TaylorMatson/Automated-Panel-Solar-Unit/High Level Design.docx

# Control Methodology

JOG

MODE

GPS

MODE

PHOTO

MODE

ARDUINO

ACTUATOR

1

ACTUATOR

2

RELAY

1

RELAY

2

RELAY

3

RELAY

4

# Power Management

Solar Panel

POWER

DISTRIBUTOR

12V BATTERY

5V USB ARDUINO

5V USB ILLUMINATED SIGN

ACTUATOR RELAYS
