TaylorMatson/Automated-Panel-Solar-Unit/Documentation/Customer Wishlist (containing the customer input, contraints, wishes, expectations).docx

Customer Wishes

CW#001

The solar panel array mounted on the unit must be 2 feet by 3 feet in area.

Taylor Matson

3/15/2021

CW#002

The branding of Austin Peay State University must be branded on the project.

Nick Calin

3/15/2021

CW#003

The unit must track the Sun to maximize power input efficiency.

Nathan Lamotte

3/15/2021

CW#004

The unit must be weatherproof and require minimal maintenance for long durations of its lifespan.

Taylor Matson

3/15/2021

CW#005

The unit must contain a microprocessor.

Nathan Lamotte

3/15/2021
