TaylorMatson/Automated-Panel-Solar-Unit/Requirement Specifications.docx

Requirement Specification

For our project to work it will need to meet all of the required specifications for maximum efficiency.

- Needs to be outside on flat land to provide stability and in view of the Sun all day.
- Needs to have enough space for both axes to move.
- This product can not withstand significant bending force during transportation & construction.
- There must be a WiFi access point called “APSU Solar Project” with the password “solarproject”
