TaylorMatson/Automated-Panel-Solar-Unit/Documentation/Mechanical Diagram.png

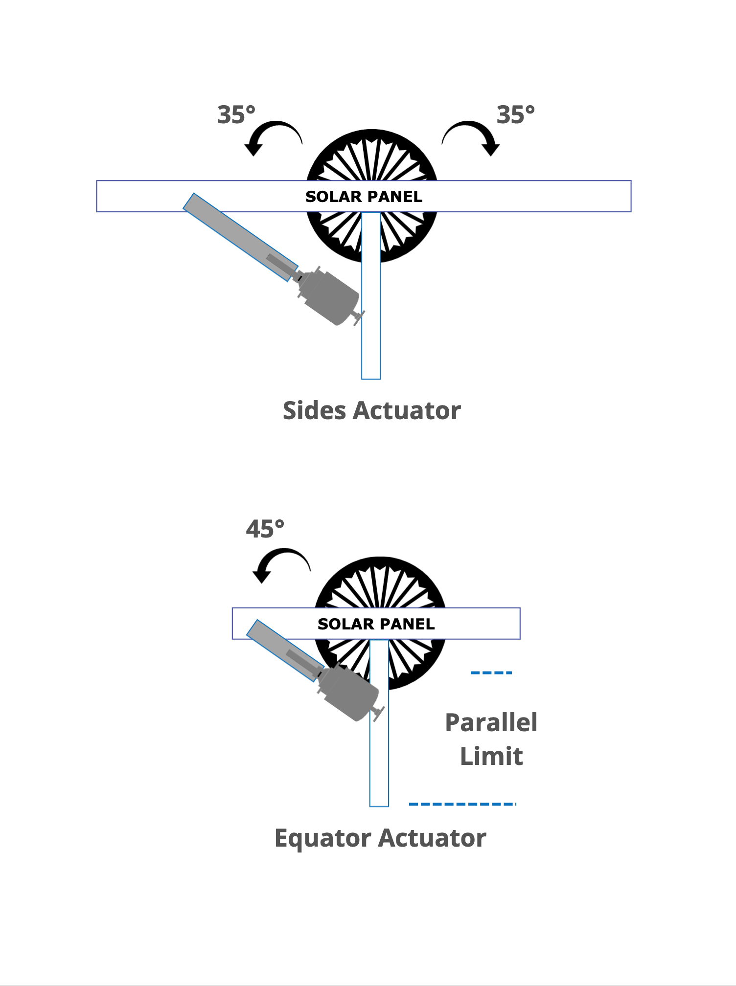
Documentation/Mechanical Diagram.png
