TaylorMatson/Automated-Panel-Solar-Unit/Electrical Diagrams/Photoresistor CIrcuit.png

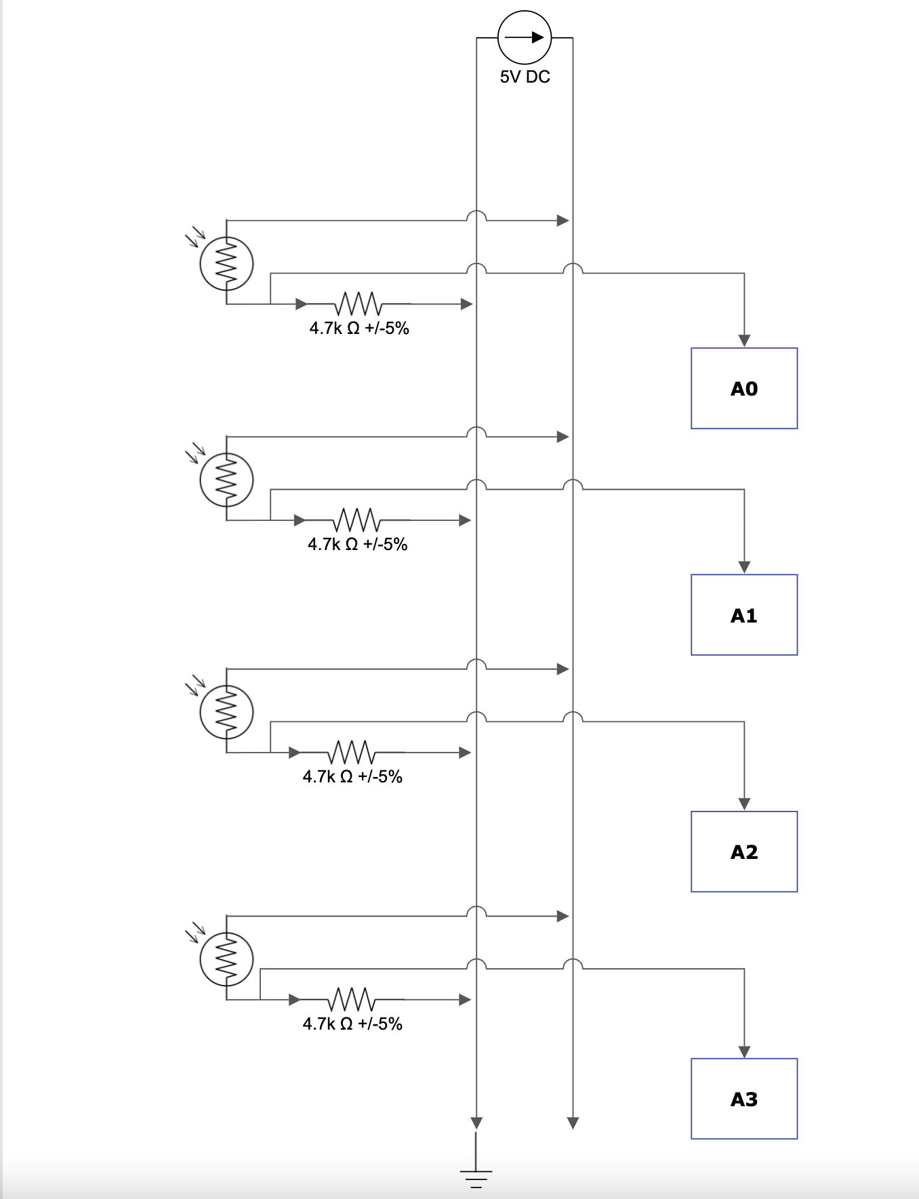
Electrical Diagrams/Photoresistor CIrcuit.png
