TaylorMatson/Automated-Panel-Solar-Unit/Electrical Diagrams/photoresistor.jpg

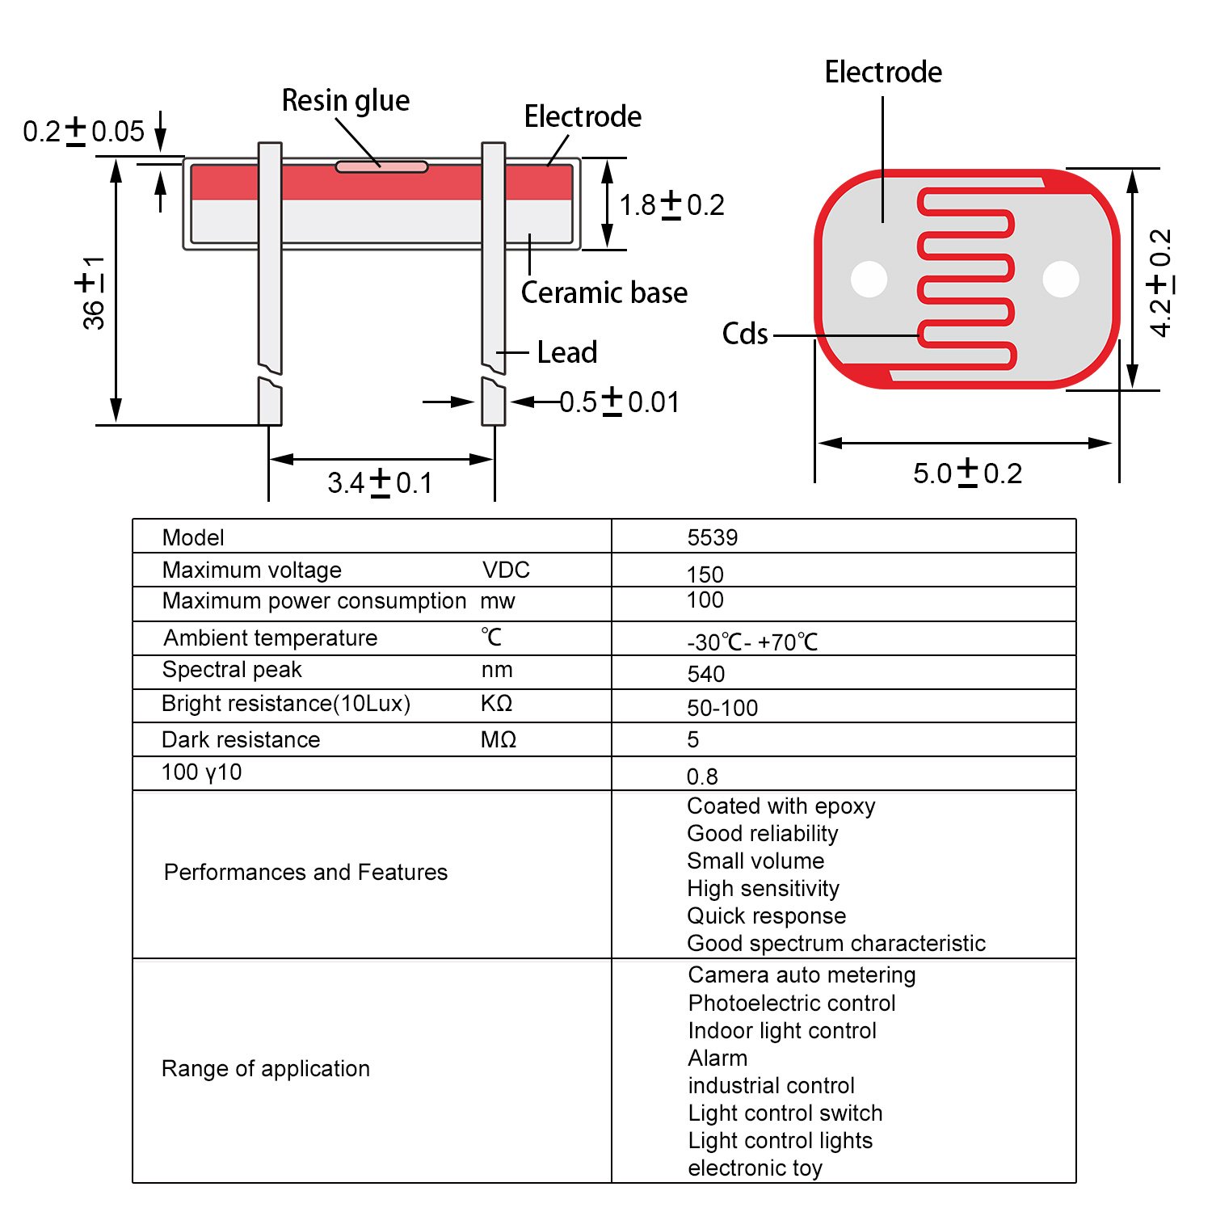
Electrical Diagrams/photoresistor.jpg
