TaylorMatson/Automated-Panel-Solar-Unit/Electrical Diagrams/Relay TO Actuator CIrcuit.PNG

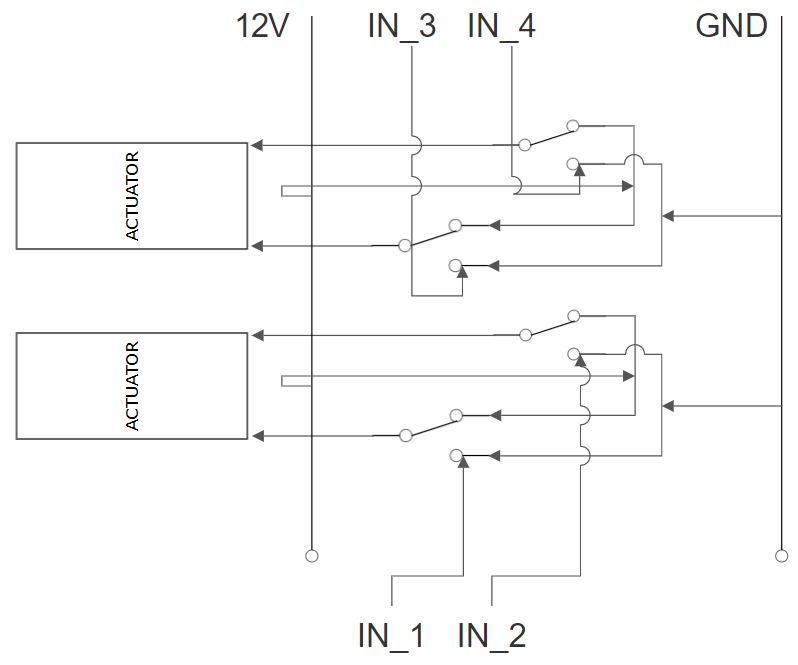
Electrical Diagrams/Relay TO Actuator CIrcuit.PNG
