TaylorMatson/Automated-Panel-Solar-Unit/Documentation/Automated Panel Solar Array Parts List.xlsx

Revised Parts List |  |  | We can pick up Grainger products physically to save on shipping costs
Electical
4 Channel Relay Module | $8.73 | 1 | https://www.amazon.com/ELEGOO-Channel-Optocoupler-Arduino-Raspberry/dp/B01HEQF5HU/?th=1
12" Actuator with Hardware | $45.87 | 1 | https://www.amazon.com/ECO-WORTHY-330lbs-Tracker-Actuator-Multi-function/dp/B00NM8H5SW
6" Actuator with Hardware | $36.25 | 1 | https://www.amazon.com/dp/B07H1TCBBV
Photoresistors | $4.97 | 1 | https://www.amazon.com/eBoot-Photoresistor-Sensitive-Resistor-Dependent/dp/B01N7V536K
Arduino WiFi | $49.01 | 1 | https://www.amazon.com/Arduino-UNO-WiFi-REV2-ABX00021/dp/B07MK598QV/ (https://www.amazon.com/HiLetgo-ATmega328P-ESP8266-NodeMCU-USB-TTL/dp/B0834JQ5Y5)
Black EEEKit 30A Solar Charge Controller | $13.10 | 1 | https://www.amazon.com/EEEKit-Controller-Intelligent-Multi-Function-Adjustable/dp/B08NQTW94B/
Solar Panel | $195.56 | 1 | https://www.amazon.com/ECO-WORTHY-Monocrystalline-Battery-Charging-Caravan/dp/B07TTSL2M6
12v Battery | $19.12 | 1 | https://www.amazon.com/ML7-12-Battery-Mighty-Brand-Product/dp/B00K8V30D0
10 and 25 Series 2 Hole Pivot Joint | $47.26 | 2 | https://www.amazon.com/80-20-Inc-14011-Pivot/dp/B07ZS1TDD6
 | $419.87
Hardware
Tee Joining Plate | $10.91 | 1 | https://www.amazon.com/Boeray-10pcs-Joining-Aluminum-Profile/dp/B01H4YPT64
Joining Plate | $47.36 | 1 | https://www.amazon.com/80-20-2-Hole-Joining-Strip/dp/B00J3TMTBW/
Fastening Hardware | $33.38 | 2 | https://www.amazon.com/80-20-Inc-Assembly-Slide/dp/B00FDSEOWY/
1/4"-20 High Speed Steel 2 Flute Spiral Point Tap | $6.06 | 1 | https://www.amazon.com/Drill-America-DWT57129-Qualtech-High-Speed/dp/B00BD5Q0BE/
Framing | $90.41 | 2 | https://www.amazon.com/gp/product/B001F0F112/
T-slot Piviot Joint | $49.33 | 2 | https://www.amazon.com/80-20-Inc-14011-Pivot/dp/B07ZS1TDD6/
 | $237.45
 | .
Total | $657.32
Purchasing Office: | tamayom@apsu.edu
Correspondant: | tmatson@my.apsu.edu
Missing From Parts Retrieval
Fastening Hardware | $33.38 | 2 | https://www.amazon.com/80-20-Inc-Assembly-Slide/dp/B00FDSEOWY/
