TaylorMatson/Automated-Panel-Solar-Unit/Documentation/External Costs.xlsx

Name | Cost
Make Nashville Membership | $105
Solar Panel Power Cables | $24.77
Photosensor Arduino Kit | $65.54
Junction Box | $31.67
 | $226.98
