TaylorMatson/Automated-Panel-Solar-Unit/2021Workbook(AutomatedPanelSolarUnit).xlsx

Sheet: 0 TOC
Project Workbook - Table of Content
ID | Title (Abbreviation) | Short decription; Instruction when to use the sheet
0 | Table of Contents (TOC) | Feel free to add other sheets as needed
1 | Project Order (PO) | Contains the initial order and key project data; This sheet is to be filled in before the project start and must not be changed during the project!
2 | Project Estimate (PE) | Contains the initial estimate (ideas, budget/costs,…); This sheet is to be filled in before the project start and must not be changed during the project!
3.x | Status per Reporting Period (ST) | This sheet contains the actual satus of the ongoing project at fixed interval times; This sheet is to be copied and filled in at each reporting interval!
4 | Customer Wishes (CW) | Statements made by the customer during meetings that have a direct influence to the project; This sheet is to be filled in after the first customer meeting and has to be updated on demand using a Change Request!
5 | User Stories (US) | The product from the view of different stakeholders and how they are going to use / produce it; This sheet is to be filled in after the first customer meeting and has to be updated on demand using a Change Request!
6 | Schedule in Hours (SH) | Contains workpackages and phases with daily time scheduling; This sheet is to be filled in at the project start and should be updated each beginning of an hour with all changes!
7 | Project Log (PL) | Contains all action items, change requests, risks, decisions that are currently open, in work or closed; This sheet is a log file and should be filled in and updated with each project change!
8 | Communication Plan (COM) | List of meeting and communication channels and Identification and management of key stakeholders for the project; This sheet is to be filled in after the first customer meeting and has to be updated on demand using a Change Request!
9 | Document Management (DOC) | Records documents used in realtion to the project.
10.x | Meeting Minutes (MM) | Use this sheet as a template for recording meetings; This sheet is to be filled in during each meeting!
11 | Revision History (REV) | Shows revision history of project workbook
12 | Change Requests (CR) | Details any Change Requests submitted along with other Action Items and risk evaluations.
13 | Glossary | Definition and description of used acronyms and terminology; This sheet is to be filled with all used acronyms!

Sheet: 1 PO
Project Title: | Automated Panel Solar Unit (APSU) |  | 0-TOC
Customer | Mr.Anderson | Planned Start Date: | 2021-03-15
Project Manager: | Taylor Matson | Planned End Date: | 2021-08-06
Document Owner: | Taylor Matson, Nathan LaMotte, Nick Calin
Project Background
Short Project Description
Dual axis soloar panel array, with integrated micro processor to automatically track the sun throughout the day to maximize solor panel output.
Decision for Starting this Project
Out of all of the project ideas we came up with, this one was calculated to be the most doable. Considering costs, construction, implementation, and timeline an Automated Panel Solar Array was our best option.
Initial Objectives
To establish a list of goals and expectations with the customer. To determine the bill of materials and timeline in which objectives would be completed.
Preliminary Scope/Requirements/Constraints
The solar panel arrary for mounted on the unit must be 2 feet by 3 feet in area. The branding of Austin Peay State University must be branded on the project. The unit must track the Sun to maximize power input effeciency. The unit must be weather proof and require minimal maitenance for long durations of its lifespan. The unit must contain a microprocessor.

Sheet: 2 PE
Preliminary Estimate
Project Title: |  | Automated Panel Solar Unit (APSU) |  |  |  |  |  |  | 0-TOC
Document Owner: |  | Taylor Matson, Nathan LaMotte, Nick Calin
Project Preliminary Estimate
Initial Solution Ideas/Alternatives
Because this is a student project, the actual cost is a profit for the institution as they take our course fees to fund our professor who oversees the project. The only cost to the institution is the material cost. Although we were budgeted $500 USD, the project would not be fulfillable as the actual least expensive and custom method we could determine is $740 USD. That being said, the institution has slack in the budget to fund us with additional finances if we need it. To what extent those additional resources are, we do not know yet.
Preliminary Internal Key Assumptions and Constraints (e.g. Timing, Resources, Process, Technology, Regulatory)
Timing restraints are dictated by the semester schedule our University imposes on courses. That being said, as student we can continue to work between semesters as the capstone course is broken up into two seperate semesters. The University is allocating a budget of $500 USD to our project with additional funds being made necessary as we need it. For us students, we are coming out of pocket for gasoline, food, and other non-essential items needed to complete this project. The technology required for this project is very simple as we only need low level programming to automate the panels actuators. We will be following the regulatory standard for electronics in outdoor settings that are for low voltage and current applications with power storage.
Initial Estimate of Project Parameters
Given Budget [€] |  |  |  | 500 €
External Consultant Cost [€] |  |  |  | 0 €
Material Costs [€] |  |  |  | 658 €
Low Cost Effort [h] |  |  |  | 400 | at pay [€] | 20 €
Mid Cost Effort [h] |  |  |  | 200 | at pay [€] | 40 €
High Cost Effort [h] |  |  |  | 150 | at pay [€] | 60 €
Planned Product Cost [€] |  |  |  | 25658 €
Budget - Costs [€] |  |  |  | -25158 €
Initial Risk Assessment
Schedule | g
Scope | g
People | g
Defects | g
Decisions | g
Costs | g
Suppliers | g
Milestones
Milestone |  | End Date | End Day | Comment
Complete Concept |  | 2021-01-30 | 2021-02-15 | Completed
Complete Systems Design |  | 2021-02-28 | 2021-03-30 | Completed
Complete Parts List |  | 2021-03-30 | 2021-04-30 | Completed
Complete Construction |  | 2021-05-30 | 2021-06-20 | Completed
Complete Final Interation |  | 2021-06-20 | 2021-07-20 | Not Initiated
Ship to Customer |  | 2021-07-20 | 2021-07-30 | Not Initiated
Initial Skill Assessment
Identify needed skills and knowledge for this project |  |  |  |  |  |  | Available | Needed | Action Item
C Programmer |  |  |  |  |  |  | x
AutoCAD Designer |  |  |  |  |  |  | x
Administration |  |  |  |  |  |  | x
Secretary/Accounting |  |  |  |  |  |  | x
Project Manager |  |  |  |  |  |  | x
Metal Shop Fabrication |  |  |  |  |  |  | x
Electrical Systems Engineer |  |  |  |  |  |  | x

Sheet: 3.1 ST
Project Status
Project Title: | Automated Panel Solar Unit (APSU) |  |  |  |  |  | 0-TOC
Date: | 2021.04.05 | 15:30:00
Document Owner: |  | Taylor Matson, Nathan LaMotte, Nick Calin
Current Project Parameters
 |  |  |  | Initial | Last Status | Spent | Available
Budget |  |  |  | 500 € | 500 € | 0 € | 500 €
Low Cost Effort |  |  |  | 500 | 500 | 0 | 500
Mid Cost Effort |  |  |  | 600 | 600 | 0
High Cost Effort |  |  |  | 700 | 700 | 0 € | 700
External Cost |  |  |  | 0 € | 0 € | 0 € | 0 €
Status
Status |  | Comments on Status (neccessary if status is yellow or red)
Schedule | g | Nothing to report
Scope | g | Nothing to report
People | g | Nothing to report
Defects | g | Nothing to report
Decisions | g | Nothing to report
Costs | g | Our parts list did go over budget but the University is allocating more resources.
Risks | g | Nothing to report
Trend | Ò
Milestones
MS 00 - Project Order |  | g | Order will be submitted within 30 days.
MS 01 - Initialization |  | g | Nothing to report
MS 02 - Execution |  | g | Nothing to report
MS 03 - Monitoring |  | g | Nothing to report
MS 04 - Closing |  | g | Nothing to report
MS 05 - Closure |  | g | Nothing to report
Key Issues and Achievements
Parts list in the process of being submitted to the budget office.

Sheet: 3.2 ST
8
Project Title: | Automated Panel Solar Unit (APSU) |  |  |  |  |  | 0-TOC
Date: | 2021.5.4 | 14:30:00
Document Owner: |  | Taylor Matson, Nathan LaMotte, Nick Calin
Current Project Parameters
 |  |  |  | Initial | Last Status | Spent | Available
Budget |  |  |  | 500 € | 658 € | 657.32 € | 0.68 €
Low Cost Effort |  |  |  | 500 | 500 | 500 | 0
Mid Cost Effort |  |  |  | 600 | 600 | 600
High Cost Effort |  |  |  | 700 | 700 | 657.32 € | 42.68
External Cost |  |  |  | 0 € | 0 € | 0 € | 0 €
Status
Status |  | Comments on Status (neccessary if status is yellow or red)
Schedule | g | Nothing to report
Scope | g | Nothing to report
People | g | Nothing to report
Defects | g | Nothing to report
Decisions | g | Nothing to report
Costs | g | Nothing to report
Risks | g | Nothing to report
Trend | Ò
Milestones
MS 00 - Project Order |  | g | Order submitted to Ms. Tamayo
MS 01 - Initialization |  | g | Nothing to report
MS 02 - Execution |  | g | Nothing to report
MS 03 - Monitoring |  | g | Nothing to report
MS 04 - Closing |  | g | Nothing to report
MS 05 - Closure |  | g | Nothing to report
Key Issues and Achievements
Initial order submitted.

Sheet: 3.3 ST
8
Project Title: | Automated Panel Solar Unit (APSU) |  |  |  |  |  | 0-TOC
Date: | 2021.6.16 | 14:30:00
Document Owner: |  | Taylor Matson, Nathan LaMotte, Nick Calin
Current Project Parameters
 |  |  |  | Initial | Last Status | Spent | Available
Budget |  |  |  | 500 € | 658 € | 657.32 € | 0.68 €
Low Cost Effort |  |  |  | 500 | 500 | 500 | 0
Mid Cost Effort |  |  |  | 600 | 600 | 600
High Cost Effort |  |  |  | 700 | 700 | 657.32 € | 42.68
External Cost |  |  |  | 0 € | 0 € | 0 € | 0 €
Status
Status |  | Comments on Status (neccessary if status is yellow or red)
Schedule | y | We are currently two meeting behind due to emergencies and incomplete work.
Scope | g
People | g
Defects | y | Arduino WiFi off brand version almost broke my computer, had to reinstall OS.
Decisions | g
Costs | r | Team is out of pocket for wiring, Make Nashville membership, and junction box.
Risks | g
Trend | Ü | Nathan and Taylor are one week behind schedule and Nick is behind 4 weeks.
Milestones
MS 00 - Project Order |  | g | External purchases we're made to fulful the project demands
MS 01 - Initialization |  | g
MS 02 - Execution |  | y
MS 03 - Monitoring |  | g
MS 04 - Closing |  | g
MS 05 - Closure |  | g
Key Issues and Achievements
Final design completed. Aluminum extrusions cut to size by Nathan.

Sheet: 3.4 ST
8
Project Title: | Automated Panel Solar Unit (APSU) |  |  |  |  |  | 0-TOC
Date: | 2021.7.6 | 14:30:00
Document Owner: |  | Taylor Matson, Nathan LaMotte, Nick Calin
Current Project Parameters
 |  |  |  | Initial | Last Status | Spent | Available
Budget |  |  |  | 500 € | 658 € | 657.32 € | 0.68 €
Low Cost Effort |  |  |  | 500 | 500 | 500 | 0
Mid Cost Effort |  |  |  | 600 | 600 | 600
High Cost Effort |  |  |  | 700 | 700 | 657.32 € | 42.68
External Cost |  |  |  | 0 € | 0 € | 227 € | 0 €
Status
Status |  | Comments on Status (neccessary if status is yellow or red)
Schedule | y | We are currently two meeting behind due to emergencies and incomplete work.
Scope | g
People | g
Defects | g
Decisions | g
Costs | r | Had to order legit Arduino WiFi and Junction Box $65.50 + $31.67
Risks | g
Trend | Ü | Nathan and Taylor are two weeks behind schedule and Nick is behind 6 weeks.
Milestones
MS 00 - Project Order |  | g
MS 01 - Initialization |  | g
MS 02 - Execution |  | g | Construction of the initial version completed with WiFi control.
MS 03 - Monitoring |  | g
MS 04 - Closing |  | g
MS 05 - Closure |  | g
Key Issues and Achievements

Sheet: 4 CW
Customer Wishes
Project Title: | Automated Panel Solar Unit (APSU) |  | 0-TOC
Document Owner: | Taylor Matson, Nathan LaMotte, Nick Calin
Customer Wish List
ID | Wish | Author | Date
CW#001 | The solar panel array mounted on the unit must be 2 feet by 3 feet in area. | Taylor Matson | 2021-03-15
CW#002 | The branding of Austin Peay State University must be branded on the project. | Nick Calin | 2021-03-15
CW#003 | The unit must track the Sun to maximize power input efficiency. | Nathan Lamotte | 2021-03-15
CW#004 | The unit must be weatherproof and require minimal maintenance for long durations of its lifespan. | Taylor Matson | 2021-03-15
CW#005 | The unit must contain a microprocessor. | Nathan Lamotte | 2021-03-15

Sheet: 5 US
User Stories
Project Title: | Automated Panel Solar Unit (APSU) |  |  | 0-TOC
Document Owner: | Taylor Matson, Nathan LaMotte, Nick Calin
User Story List
ID | Related Wish ID (if possible) | User Story | Author | Date
US#001 |  | Customer needs this solar array to track the sun for maximum efficiency. Because the university is receiving a grant for new innovations in global warming research, the project needs to provide accurate data that scientists across the world can use. | Mattew Anderson | 3.15.2021
US#002
US#003
US#004
US#005
Invest | Meaning | Description
I | Independent | The user story should be self-contained, in a way that there is no inherent dependency on another user story.
N | Negotiable | User stories, up until they are part of an implementation, can always be changed and rewritten.
V | Valuable | A user story must deliver value to the end user.
E | Estimable | You must always be able to estimate the size of a user story.
S | Small | User stories should not be so big as to become impossible to plan/task/prioritize with a certain level of certainty.
T | Testable | The user story or its related description must provide the necessary information to make test development possible.

Sheet: 6 SD
Schedule
Project Title: | Automated Panel Solar Unit (APSU) |  |  |  |  | 0-TOC | Current Day: |  |  |  |  | 64.78681794
Work Packages |  |  |  |  |  |  | Time Schedule in d
 |  |  |  |  |  | Calender Week | 42 | 42 | 42 | 42 | 42 | 43 | 43 | 43 | 43 | 43 | 44 | 44 | 44 | 44 | 44 | 45 | 45 | 45 | 45 | 45 | 46 | 46 | 46 | 46 | 46 | 47 | 47 | 47 | 47 | 47 | 48 | 48 | 48 | 48 | 48 | 49 | 49 | 49 | 49 | 49 | 50 | 50 | 50 | 50 | 50 | 51 | 51 | 51 | 51 | 51 | 52 | 52
ID | Predecessor ID (if existing) | Responsible Person | Start | Planned End | Adjusted End | Percentage of Completion (estimate) | 1 | 2 | 3 | 4 | 5 | 6 | 7 | 8 | 9 | 10 | 11 | 12 | 13 | 14 | 15 | 16 | 17 | 18 | 19 | 20 | 21 | 22 | 23 | 24 | 25 | 26 | 27 | 28 | 29 | 30 | 31 | 32 | 33 | 34 | 35 | 36 | 37 | 38 | 39 | 40 | 41 | 42 | 43 | 44 | 45 | 46 | 47 | 48 | 49 | 50 | 51 | 52
1 |  | Taylor Matson | 2 | 16 | 22 | 100% | 1 | 2 | 3 | 4 | 5 | 6 | 7 | 8 | 9 | 10 | 11 | 12 | 13 | 14 | 15 | 16 | 17 | 18 | 19 | 20 | 21 | 22 | 23 | 24 | 25 | 26 | 27 | 28 | 29 | 30 | 31 | 32 | 33 | 34 | 35 | 36 | 37 | 38 | 39 | 40 | 41 | 42 | 43 | 44 | 45 | 46 | 47 | 48 | 49 | 50 | 51 | 52
2 |  | Taylor Matson | 15 | 16 | 16 | 100% | 1 | 2 | 3 | 4 | 5 | 6 | 7 | 8 | 9 | 10 | 11 | 12 | 13 | 14 | 15 | 16 | 17 | 18 | 19 | 20 | 21 | 22 | 23 | 24 | 25 | 26 | 27 | 28 | 29 | 30 | 31 | 32 | 33 | 34 | 35 | 36 | 37 | 38 | 39 | 40 | 41 | 42 | 43 | 44 | 45 | 46 | 47 | 48 | 49 | 50 | 51 | 52
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
27 |  |  |  |  |  | 0% | 1 | 2 | 3 | 4 | 5 | 6 | 7 | 8 | 9 | 10 | 11 | 12 | 13 | 14 | 15 | 16 | 17 | 18 | 19 | 20 | 21 | 22 | 23 | 24 | 25 | 26 | 27 | 28 | 29 | 30 | 31 | 32 | 33 | 34 | 35 | 36 | 37 | 38 | 39 | 40 | 41 | 42 | 43 | 44 | 45 | 46 | 47 | 48 | 49 | 50 | 51 | 52
28 |  |  |  |  |  | 0% | 1 | 2 | 3 | 4 | 5 | 6 | 7 | 8 | 9 | 10 | 11 | 12 | 13 | 14 | 15 | 16 | 17 | 18 | 19 | 20 | 21 | 22 | 23 | 24 | 25 | 26 | 27 | 28 | 29 | 30 | 31 | 32 | 33 | 34 | 35 | 36 | 37 | 38 | 39 | 40 | 41 | 42 | 43 | 44 | 45 | 46 | 47 | 48 | 49 | 50 | 51 | 52
29 |  |  |  |  |  | 0% | 1 | 2 | 3 | 4 | 5 | 6 | 7 | 8 | 9 | 10 | 11 | 12 | 13 | 14 | 15 | 16 | 17 | 18 | 19 | 20 | 21 | 22 | 23 | 24 | 25 | 26 | 27 | 28 | 29 | 30 | 31 | 32 | 33 | 34 | 35 | 36 | 37 | 38 | 39 | 40 | 41 | 42 | 43 | 44 | 45 | 46 | 47 | 48 | 49 | 50 | 51 | 52
30 |  |  |  |  |  | 0% | 1 | 2 | 3 | 4 | 5 | 6 | 7 | 8 | 9 | 10 | 11 | 12 | 13 | 14 | 15 | 16 | 17 | 18 | 19 | 20 | 21 | 22 | 23 | 24 | 25 | 26 | 27 | 28 | 29 | 30 | 31 | 32 | 33 | 34 | 35 | 36 | 37 | 38 | 39 | 40 | 41 | 42 | 43 | 44 | 45 | 46 | 47 | 48 | 49 | 50 | 51 | 52

Sheet: 7 PL
Project Log
Project Title: | Automated Panel Solar Unit (APSU) | Last Changed: | 2021.05.04 |  |  | 0-TOC
Document Owner: | Taylor Matson, Nathan LaMotte, Nick Calin
Action Items
ID | Topic | Status | Responsible | Changes | Opened Date | Follow Up Date
1 | Pick up parts from APSU | Closed | Taylor Matson | 06.03: Initial Inventory 06.09: Reported missing parts 06.22: Picked up missing parts | 2021-06-02 | 2015-06-22
2 | Generate progress report for customer | Closed | Taylor Matson |  | 2021-06-15 | 2021-06-16
3 | Generate all documentation required as templates for project manager | In Work | Nick Calin | 06.16: No progress reported 06.24: No progress reported 07.05: Requirements met for Midterm 08.01: Taylor Matson taking over work | 2021-06-01 | 2021-05-14
4 | Complete Final Design | Closed | Taylor Matson, Nathan Lamotte | 06.08: Internal review 06.16: Design completed | 2021-06-01 | 2021-06-16
5 | Cut extrusions to size | Closed | Nathan Lamotte |  | 2021-06-15 | 2021-06-25
6 | Assemble the system excluding the Arduino and test actuators | Closed | Taylor Matson, Nathan Lamotte, Nick Calin | 04.15: Nick vehicle emergency | 2021-06-15 | 2021-06-25
7 | Create a manual control system using the Arduino and internet | Closed | Taylor Matson | 06.25: Arduino fake did not work 07.06: Official Arduino came in 07.07: Motor control demo | 2021-06-25 | 2021-07-06
8 | Generate progress report for customer | Closed | Taylor Matson |  | 2021-06-25 | 2021-07-06
9 | 3D Print mounts for photoresistors | Closed | Nathan Lamotte |  | 2021-07-07 | July20th
10 | Create an electrical circuit for the photoresistors that integrates into the solar panel seemlessly | Closed | Taylor Matson |  | 2021-07-07 | July20th
11 | Create metal 2 hole joiners and 3 hole joiners for the new base. | Closed | Nick Calin |  | 2021-07-07 | July20th
12 | Create a new base made from 1" steel tubing | Closed | Nick Calin |  | 2021-07-07 | July20th
13 | Cut the existing base extrusions to create 45 degree supports | Closed | Nathan Lamotte |  | 2021-07-07 | July20th
14 | Integrate photoresistor control into arduino configuration | Closed | Taylor Matson |  | 2021-07-07 | July 20th
AI#001 | Gain Programming Skills
AI#002
AI#003
AI#004
AI#005
AI#006
AI#007
AI#008
AI#009
AI#010
15 | build out junction box with connections and wires | Closed | Taylor Matson |  | July 20th | July 26th
16 | improve code and add connectivity | Closed | Taylor Matson |  | July 20th | July 26th
17 | 3d print and implement illuminated sign usb powered | Closed | Nathan Lamotte |  | July 20th | July 26th
18 | document manual | In Work | Nick Calin |  | July 20th | July 26th
19 | blue the steel base | Closed | Nick Calin |  | July 20th | July 28th
20 | powerpoint presentation | In Work | Nathan Lamotte |  | July 20th | July 28th
21 | fill out every document | In Work | Taylor Matson |  | July 20th | July 28th
Change Requests
ID | Topic | Status | Responsible | Changes | Opened Date | Follow Up Date
Example#01 | Motor needs to provide more power | In Work | Philipp Paus | 05.09: Customer request 07.09: Re-Calculation of Motor 10.09: … | 2015-09-05 | 2015-09-10
CR#001
CR#002
CR#003
CR#004
CR#005
CR#006
CR#007
CR#008
CR#009
CR#010
Risks
ID | Topic | Status | Responsible | Changes | Opened Date | Follow Up Date | Probability | Impact
R1

Sheet: 8 COM
Communication
Project Title: | Automated Panel Solar Unit (APSU) |  |  | 0-TOC
Document Owner: | Taylor Matson, Nathan LaMotte, Nick Calin
Project Team and Key Stakeholders
Stakeholder / Team Member Name | Role | Responsibility / Function |  | Contact Info
Taylor Matson | Lead-Project Manager | The lead to planning the project and driving it to completion |  | tmatson@apsu.edu
Nathan LaMotte | Designer | Materials and system design coordinator. |  | nlamotte@my.apsu.edu
Nick Calin | Secretary | Data reporting and analytics from documentation. |  | ncalin@apsu.edu
Communication Plan
Communication Mechanism | Prepared, sent by | Addressee,Target Group | Objective, Agenda | Frequency, Day, Time
Initial Customer Meeting | Taylor Matson | Matthew Anderson | Gather first information about the customer wishes. | Once, 02.23.2021
Second Customer Meeting | Taylor Matson | Matthew Anderson | Project timeline, material selection, and ordering materials | Once, 03.16.2021
Third Customer Meeting | Taylor Matson | Matthew Anderson | Affirmation of goals, procedures, and next steps. | Once, 04.20.2021
Fourth Customer Meeting | Taylor Matson | Matthew Anderson | Final design submission and initial constuction. | Once, 06.17.2021
Physical Team Meeting One | Taylor Matson | A.P.S.U. Team | Inventory review. Final design review. | Once, 06.16.2021
Physical Team Meeting Two | Taylor Matson | A.P.S.U. Team | Cutting aluminum extrusions to size. | Once, 06.23.2021
Physical Team Meeting Three | Taylor Matson | A.P.S.U. Team | Initial construction. | Once, 06.29.2021
Fifth Customer Meeting | Taylor Matson | Matthew Anderson | Demo of progress. | Once, 07.07.2021

Sheet: 9 DOC
DOCUMENT MANAGEMENT AND BASELINES
REFERENCE TABLE
Document / Work Product (any configuration item) | ID | Owner | Category | Directory/ID | Baseline 1 (date/version) | Baseline x (date/version)
Project Workbook | XY_01 | CHE | Plan/Spec/Doc | VCAT Link | 01.04.14 draft | 01.04.14 draft
Project Management Work Products
Project Workbook (this document, covering estimation, schedule, status, action items, risks, doc.mgmt, stakeholders, change request) | PM_01 | Taylor Matson | Plan/Spec/Doc | Taylor Matson Google Drive/MECH Capstone/ | 03.15/1.0 | 5/4/2021 v1.1
Customer Wishlist (containing the customer input, contraints, wishes, expectations) | PM_02 | Taylor Matson | Plan/Spec/Doc | Taylor Matson Google Drive/MECH Capstone/ | 03.15/1.0 | 5/4/2021 v1.0
User Stories (resulting from analyzing the customer wishes; understanding the problem to be solved, involving the customer, achieving a common understanding) | PM_03 | Nick Calin | Plan/Spec/Doc | Taylor Matson Google Drive/MECH Capstone/ | 03.15/1.0 | 5/4/2021 v1.0
Requirement Specifications (documentation of required functionality (scope) of the system including quality attributes) | PM_04 | Taylor Matson | Plan/Spec/Doc | Taylor Matson Google Drive/MECH Capstone/ | 03.15/1.0 | 5/4/2021 v1.0
System and Component Test Plan (documenting how, when, how often the implementation of the requirements will be verified) | PM_05 | Taylor Matson | Plan/Spec/Doc | Taylor Matson Google Drive/MECH Capstone/ | 03.15/1.0 | 5/4/2021 v1.0
...<add as needed>
Engineering Work Products
System Level Work Products
Technical System Specifications (External interfaces incl. Environment/Hazard Analysis/Applicable Standards/Norms) | SY_01 | Taylor Matson | Plan/Spec/Doc | Taylor Matson Google Drive/MECH Capstone/ | 03.15/1.0 | 5/4/2021 v1.0
High Level Design (Block Diagram and System Layout) | SY_02 | Nick,Taylor,Nathan | Plan/Spec/Doc | Taylor Matson Google Drive/MECH Capstone/ | 03.15/1.0 | 5/4/2021 v1.0
Bill of Material (list of all components and parts; including constraints given by stakeholders) | SY_03 | Nathan Lamotte | BoM | Taylor Matson Google Drive/MECH Capstone/ | 03.15/1.0 | 5/4/2021 v1.0
Component/Part Datasheets (details related to individual parts, conformance to constraints given by stakeholders) | SY_04 | Nathan Lamotte | Plan/Spec/Doc | Taylor Matson Google Drive/MECH Capstone/ | 03.15/1.0 | 5/4/2021 v1.0
System Test Criteria | SY_05 | Nick, Taylor, Nathan | Plan/Spec/Doc | Taylor Matson Google Drive/MECH Capstone/ | 03.15/1.0 | 5/4/2021 v1.0
System Test Reports | SY_06 | Nick Calin | Plan/Spec/Doc | Taylor Matson Google Drive/MECH Capstone/ | 03.15/1.0 | 5/4/2021 v1.0
User Manual (safety aspects, machine handling, error handling, signal interpretation) | SY_07 | Nick Calin | Plan/Spec/Doc | Taylor Matson Google Drive/MECH Capstone/ | 03.15/1.0 | 5/4/2021 v1.0
...<add as needed>
Mechanical Work Products
Setup Plan (containing system and machine layout on high level, dimensioning, conforming to constraints given by stakeholders) | ME_01 | Taylor Matson | Plan/Spec/Doc | Taylor Matson Google Drive/MECH Capstone/ | 03.15/1.0 | 5/4/2021 v1.0
Mechanical Diagram/Drawing (as basis for construction/production) | ME_02 | Taylor Matson | Layout/Drawing | Taylor Matson Google Drive/MECH Capstone/ | 03.15/1.0 | 5/4/2021 v1.0
...<add as needed>
Electrical Work Products
Electrical Layout (e.g., positioning of el.cabinets, panels, cabeling, terminal boxes, interfaces, conforming to constraints given by stakeholders) | EL_01 | Nick,Taylor,Nathan | Layout/Drawing | Taylor Matson Google Drive/MECH Capstone/ | 03.15/1.0 | 5/4/2021 v1.0
Wiring Diagram (basis for el.construction / production, terminal list, PLC components) | EL_02 | Nick, Taylor, Nathan | Layout/Drawing | Taylor Matson Google Drive/MECH Capstone/ | 03.15/1.0 | 5/4/2021 v1.0
...<add as needed>
Software Work Products
Step Diagram (low level SW design, flow chart of functionality) | SW_01 | Nick,Taylor,Nathan | Plan/Spec/Doc | Taylor Matson Google Drive/MECH Capstone/ | 03.15/1.0 | 5/4/2021 v1.0
Arduino Program (commented code; structured; e.g., statement list or function block or ladder diagram, conforming to constraints given by stakeholders) | SW_02 | Nick,Taylor,Nathan | Code Label | Taylor Matson Google Drive/MECH Capstone/ | 03.15/1.0 | 5/4/2021 v1.0
...<add as needed>
Supporting Documents
Meeting Minutes | SU_01 | Nick Calin | Plan/Spec/Doc | Taylor Matson Google Drive/MECH Capstone/ | 03.15/1.0 | 5/4/2021 v1.0
Status Reports (if status template is not used) | SU_03 | Nick Calin | Plan/Spec/Doc | Taylor Matson Google Drive/MECH Capstone/ | 03.15/1.0 | 5/4/2021 v1.0
Emails (from/to customer/supplier) | SU_04 | Nick,Taylor,Nathan | Tool | Taylor Matson Google Drive/MECH Capstone/ | 03.15/1.0 | 5/4/2021 v1.0
Lessons Learned (at the end of the project; feedback on both process and project success and possible improvements) | SU_05 | Nick Calin | Plan/Spec/Doc | Taylor Matson Google Drive/MECH Capstone/ | 03.15/1.0 | 5/4/2021 v1.0
...<add as needed>

Sheet: 10.1 MM
Minutes of Meeting
Project Title: | Automated Panel Solar Unit (APSU) |  |  |  | 0-TOC
Document Owner: | Taylor Matson, Nathan Lamotte, Nick Calin |  |  |  |  | <name of document owner>
General Information
Topic |  |  | Date / Time | Place
Project Specifics |  |  | 4PM CST | Zoom
Participants
Name |  |  | Role | Contact
Taylor Matson |  |  | Project Manager | Tmatson@my.apsu.edu
Nathan Lamotte |  |  | Designer | Nlamotte@my.apsu.edu
Nick Calin |  |  | Secretary | Ncalin@my.apsu.edu
Mattew Anderson |  |  | Customer | Andersonm@apsu.edu
Agenda and Minutes
2021-02-11 | Nathan Lammote Nick Calin Taylor Matson | In this meeting we discussed the organization and jobs of the group. Taylor is Project Manager, Nathan is in charge of design and concept, and Nick is the secretary |  |  | 5:00PM through 8:00PM
2021-02-23 | Nathan Lammote Nick Calin Taylor Matson Mattew Anderson | Gathered first information about the customers wishes. |  |  | class time
2021-03-15 | Nathan Lammote Nick Calin Taylor Matson | In this meeting we discussed ideas on how to design the solar array. Taylor spoke about the requirements that the customer had, and on how we should implement them. Nathan spoke about the design concepts for the solar array. Nick wrote down the ideas and concepts |  |  | 6:00PM through 9:00PM
2021-03-16 | Nathan Lammote Nick Calin Taylor Matson Mattew Anderson | Project timeline,material selection, and ordering materials. |  |  | class time
2021-03-30 | Nathan Lammote Nick Calin Taylor Matson | In this meeting we discussed the organization and jobs of the group. Taylor is Project Manager, Nathan is in charge of design and concept, and Nick is the secretary |  |  | 6:00PM through 9:00PM
2021-04-20 | Nathan Lammote Nick Calin Taylor Matson Mattew Anderson | Affirmation of goal, procedures, and next steps |  |  | Class time
2021-04-21 | Nathan Lammote Nick Calin Taylor Matson | In this meeting we discussed the cost and parts we need to manufacture the solar array. Nathan pitched his ideas for the design construction of the mechanical parts as well as parts. Taylor pitched his ideas for the electrical construction, as well as parts. Nick wrote down a parts list as well as websites on where to buy. Nick also discussed parts that he can get from his work for free |  |  | 5:00PM through 10:00PM

Sheet: 10.2 MM
Minutes of Meeting
Project Title: | Automated Panel Solar Unit (APSU) |  |  |  | 0-TOC
Document Owner: | Taylor Matson, Nathan Lamotte, Nick Calin
General Information
Topic |  |  | Date / Time | Place
Project Specifics |  |  | 4PM CST | Zoom
 |  |  |  | Make Nashville
Participants
Name |  |  | Role | Contact
Taylor Matson |  |  | Project Manager | Tmatson@my.apsu.edu
Nathan Lamotte |  |  | Designer | Nlamotte@my.apsu.edu
Nick Calin |  |  | Secretary | Ncalin@my.apsu.edu
Mattew Anderson |  |  | Customer | Andersonm@apsu.edu
Agenda and Minutes
2021-06-16 | Nathan Lammote Nick Calin Taylor Matson | In this meeting we discussed the parts and set up of the solar panel array at Make Nashville. Nathan and Taylor was involved with the inventory count. Nick was in Chattanooga for work. He couldn't make it due to the shut down of Volkswagen plant. |  |  | 1:40PM through 4:05PM
2021-06-17 | Nathan Lammote Nick Calin Taylor Matson | In this meeting we discussed what additional parts we need. Nick said he could bring most of the parts to Make Nashville. |  |  | 1:30pm to 2:00pm
2021-06-23 | Nathan Lammote Nick Calin Taylor Matson | In this meeting, Nick could not make it due to his work in Chattanooga for the shut down of Volkswagen. Taylor and Nathan started measuring and cutting the aluminum framing. |  |  | 3:00PM through 4:00PM
2021-06-29 | Nathan Lammote Nick Calin Taylor Matson | In this meeting Nick couldn't make it due to the shut down for Volkswagen and was in Chattanooga for work. Nathan and Taylor started assembling the solar array aluminum frame to the solar panel. |  |  | 1:40pm through 4:50pm
2021-07-07 | Nathan Lammote Nick Calin Taylor Matson Mattew Anderson | In this meeting we discussed the project and what we got done, Nathan couldn’t make it due to his work. The customer (Professor Anderson) had some questions about the progress of the solar panel array |  |  | 10:00am to 3:00pm
2021-07-21 | Nathan Lammote Nick Calin Taylor Matson | In this meeting we worked on the brackets to make the aluminum post stronger than what it was before, Nathan and I worked on that, while Taylor worked on the software and the wiring. |  |  | 5:00 pm to 4:00am
2021-07-27 | Nathan Lammote Nick Calin Taylor Matson | In this meeting we worked on bluing the metal and doing the electrical harness and testing it. We tested the photoresistors to make sure they are collecting the data |  |  | 2:00pm to 6:00pm
2021-07-28 | Nathan Lammote Nick Calin Taylor Matson | In this review meeting we assembled everything to make sure everything was running properly, that night we fried the bread board and other components on it. The next day we started troubleshooting it and tried to fix it. |  |  | 5:00pm to 6:00am

Sheet: 11 REV
REVISION TABLE OF THIS DOCUMENT
Date | Version | Author | This was changed
2021.3.14 | V1.0 | Taylor Matson, Nathan LaMotte, Nick Calin | The document was created and the intial required data was inserted.
2021.5.04 | V1.1 | Taylor Matson, Nathan LaMotte, Nick Calin | All pages were filled with the minimum data to suffice for initiation of the project. Some pages were completed.
2021.7.06 | V1.2 | Taylor Matson, Nick Calin | Added physical meetings and scheduled work.

Sheet: 12 CR
Status | opened (date) | Action / Risk / Change / Decision / Info Description | Responsible | Due Date | Follow-up Date | Comments/Log/History/related AI | Risk Probability | Risk Impact
In Work | 2012-08-01 | Feasibility Study, Workshop or Meeting with customer | CHE | 2012-08-30 | 2012-08-25 | 2.8: internal Review 3.8: feedback from supplier 10.8: … | Medium | High
Open | 2012-08-01 | Finish Project Schedule based on discipline input | CHE | 2012-08-30 | 2012-08-25 | waiting for input
In Work | 05.04.2021 | Submit parts list for ordering to business office. | Taylor Matson | 05.04.2021 | 05.15.2021 | All items converted to Amazon listings. Ready to submit. | Low | High

Sheet: 13 Glossary
Glossary
Project Title: | Automated Panel Solar Unit (APSU)
Glossary
Acronym/Term | Description/Explanation
AI | Action Item
CR | Change Request
PE | Project Estimate
ST | Status per Reporting Period
CW | Customer Wishes
US | User Stories
SH | Schedule in Hours
PL | Project Log
DM | Document Management
COM | Communication Plan
MM | Meeting Minutes
TOC | Table of Content
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
