TaylorMatson/Automated-Panel-Solar-Unit/Documentation/Lessons Learned.docx

Taylor:

How to program the wifi chip on Arduino.

How to filter photoresistor data to be usable by the Arduino.

Nathan:

How to 3D Print objects around standardized components.

Nick:

How to Blue steel.
