TaylorMatson/Automated-Panel-Solar-Unit/Documentation/High Level Design.pdf

## Control Methodology

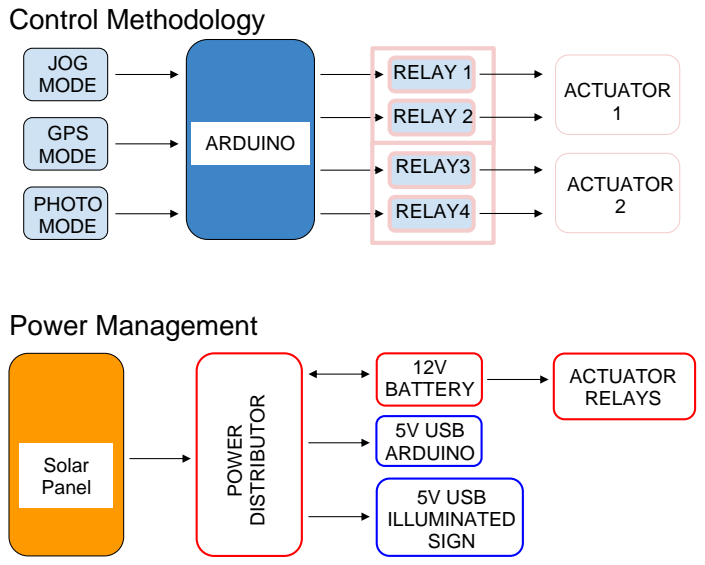
[picture p18: page 1]
Power Management; JOG MODE; GPS MODE; PHOTO MODE; ARDUINO; ACTUATOR 1; ACTUATOR 2; RELAY 1; RELAY 2; RELAY3; RELAY4; Solar Panel; POWER; DISTRIB; UTOR; 12V BATTERY; 5V USB ARDUINO; 5V USB ILLUMINATED SIGN; ACTUATOR RELAYS
