TaylorMatson/Automated-Panel-Solar-Unit/(commit log)

2024-06-28 folder restructure
    [2021Workbook(AutomatedPanelSolarUnit).xlsx]
2024-06-29 file update
    [2021Workbook(AutomatedPanelSolarUnit).xlsx, Automated Panel Solar Array Parts List.xlsx, External Costs.xlsx]
